wsh32/firefly/hardware/dwm1000_arduino/outs/dwm1000_arduino.pdf

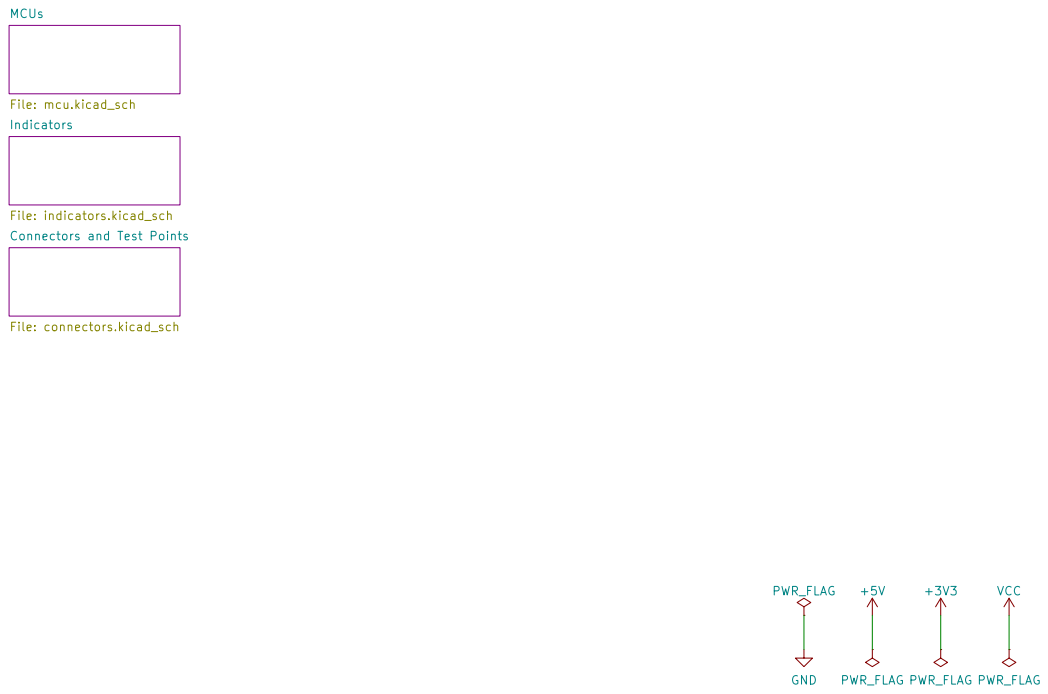
[picture p1: page 1]

Designer: Wesley Soo-Hoo
File: dwm1000_arduino.kicad_sch Sheet: / Olin Robotics - Project Firefly

Id: 1/4 Title: DWM1000 Arduino Breakout

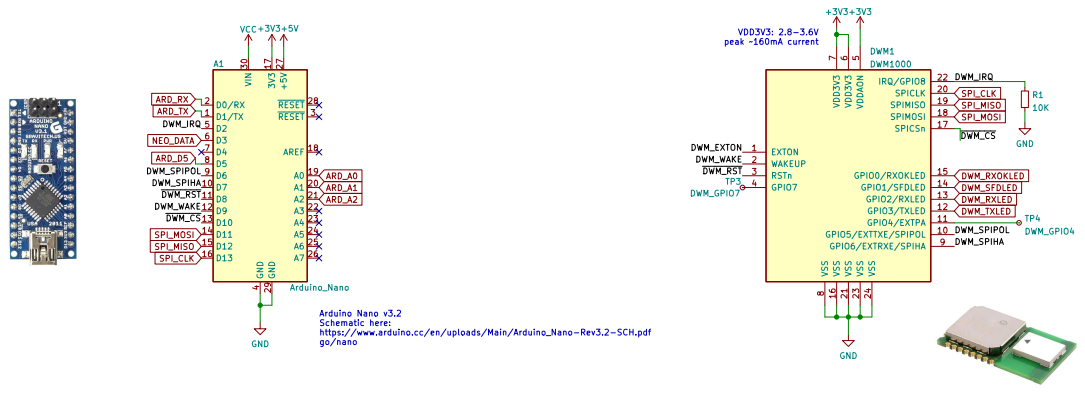
[picture p2: page 2]

~{DWM_CS} Arduino Nano v3.2 Schematic here: https://www.arduino.cc/en/uploads/Main/Arduino_Nano-Rev3.2-SCH.pdf

Designer: Wesley Soo-Hoo
File: mcu.kicad_sch Sheet: /MCUs/ Olin Robotics - Project Firefly

Id: 2/4 Title: DWM1000 Arduino Breakout

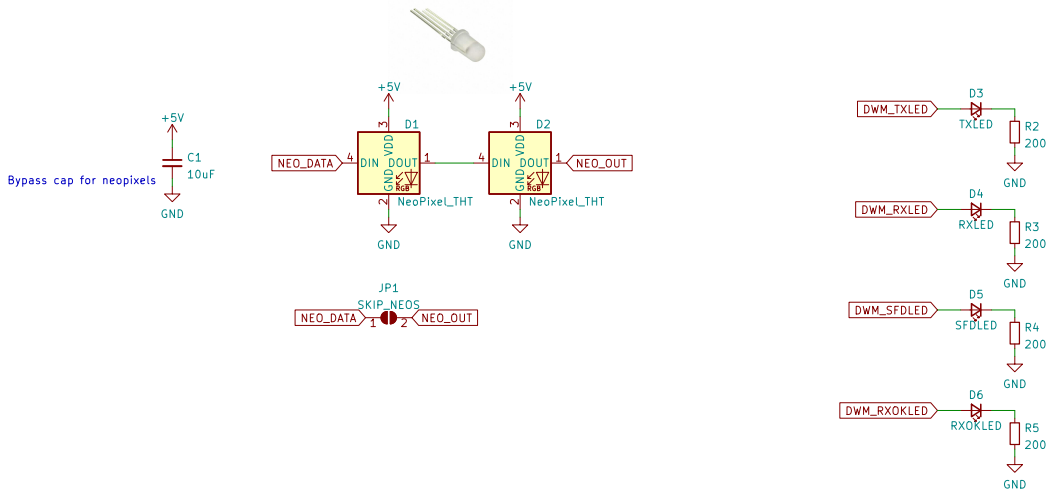
[picture p3: page 3]

NEO_OUT Bypass cap for neopixels

Designer: Wesley Soo-Hoo GND

File: indicators.kicad_sch Sheet: /Indicators/ Olin Robotics - Project Firefly

Id: 3/4 Title: DWM1000 Arduino Breakout

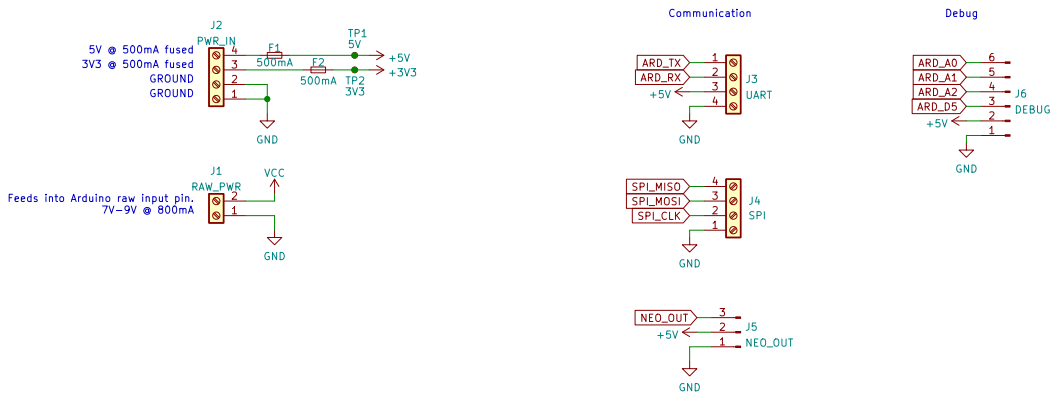
[picture p4: page 4]

Designer: Wesley Soo-Hoo
File: connectors.kicad_sch Sheet: /Connectors and Test Points/ Olin Robotics - Project Firefly

Id: 4/4 Title: DWM1000 Arduino Breakout
