wsh32/firefly/hardware/dwm1000_arduino/dwm1000_arduino.kicad_pcb

## KiCad design hardware/dwm1000_arduino/dwm1000_arduino.kicad_pcb (2022-02-15)

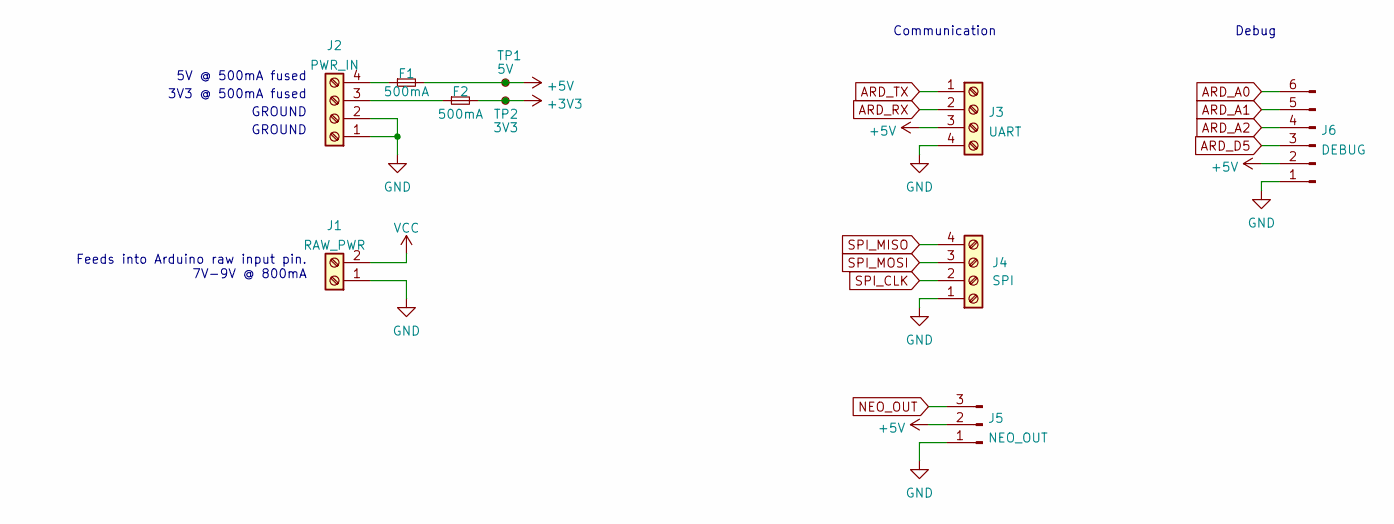
[picture p5: schematic connectors.kicad_sch, DWM1000 Arduino Breakout]

Parts:
F1, F2: 500mA; Fuse_1206_3216Metric_Pad1.42x1.75mm_HandSolder; DigiKey 507-1802-6-ND
J1: RAW_PWR; TerminalBlock_Phoenix_PT-1,5-2-3.5-H_1x02_P3.50mm_Horizontal; DigiKey 277-15481-ND
J2: PWR_IN; TerminalBlock_Phoenix_PT-1,5-4-3.5-H_1x04_P3.50mm_Horizontal; DigiKey 277-1860-ND
J3: UART; TerminalBlock_Phoenix_PT-1,5-4-3.5-H_1x04_P3.50mm_Horizontal; DigiKey 277-1860-ND
J4: SPI; TerminalBlock_Phoenix_PT-1,5-4-3.5-H_1x04_P3.50mm_Horizontal; DigiKey 277-1860-ND
J5: NEO_OUT; PinHeader_1x03_P2.54mm_Vertical
J6: DEBUG; PinHeader_1x06_P2.54mm_Vertical
TP1: 5V; TestPoint_Pad_D2.5mm
TP2: 3V3; TestPoint_Pad_D2.5mm

Connections:
+3V3: F2.2, TP2.1; also elsewhere on the board
+5V: F1.2, J3.3, J5.2, J6.2, TP1.1; also elsewhere on the board
ARD_A0: J6.6; also elsewhere on the board
ARD_A1: J6.5; also elsewhere on the board
ARD_A2: J6.4; also elsewhere on the board
ARD_D5: J6.3; also elsewhere on the board
ARD_RX: J3.2; also elsewhere on the board
ARD_TX: J3.1; also elsewhere on the board
GND: J1.1, J2.1, J2.2, J3.4, J4.1, J5.1, J6.1; also elsewhere on the board
NEO_OUT: J5.3; also elsewhere on the board
unnamed: F1.1, J2.4
unnamed: F2.1, J2.3
SPI_CLK: J4.2; also elsewhere on the board
SPI_MISO: J4.4; also elsewhere on the board
SPI_MOSI: J4.3; also elsewhere on the board
VCC: J1.2; also elsewhere on the board

Notes on the sheet:
GROUND
Feeds into Arduino raw input pin. 7V-9V @ 800mA
5V @ 500mA fused
Communication
3V3 @ 500mA fused
Debug

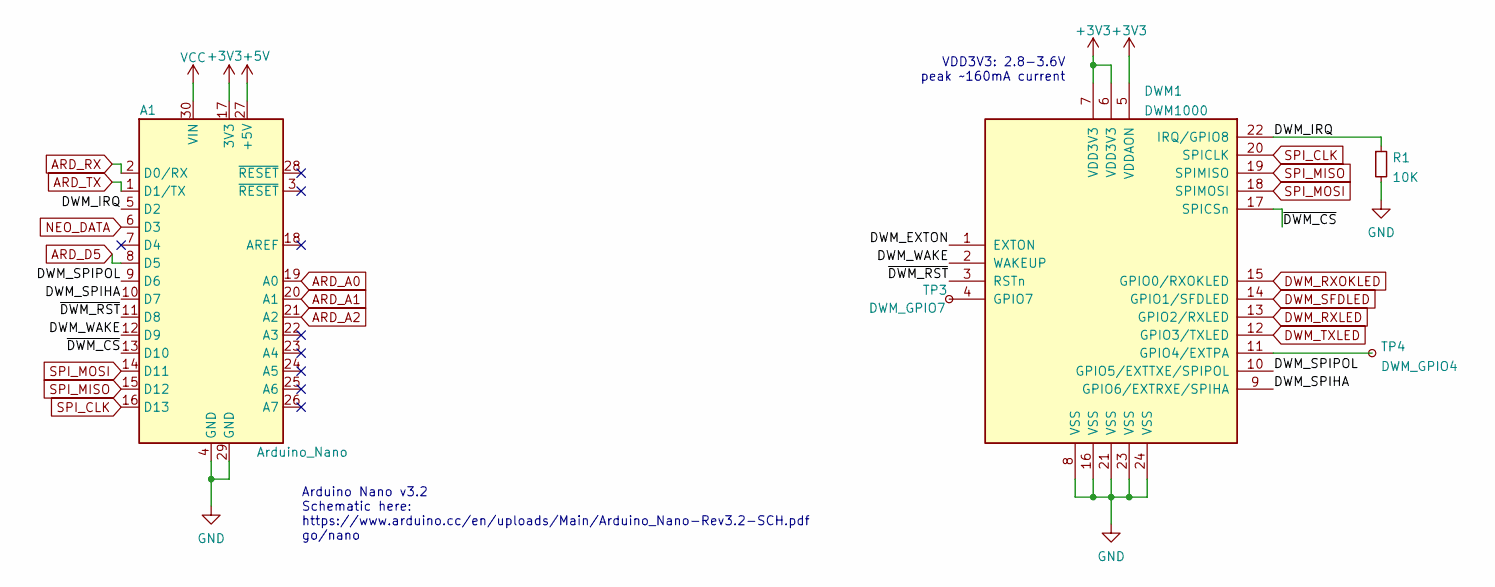
[picture p6: schematic mcu.kicad_sch, DWM1000 Arduino Breakout]

Parts:
A1: Arduino_Nano
DWM1: DWM1000
R1: 10K; R_0805_2012Metric_Pad1.20x1.40mm_HandSolder; DigiKey RMCF0805JT10K0DKR-ND
TP3: DWM_GPIO7
TP4: DWM_GPIO4

Connections:
+3V3: A1.17 (3V3), DWM1.5 (VDDAON), DWM1.6 (VDD3V3), DWM1.7 (VDD3V3); also elsewhere on the board
+5V: A1.27 (+5V); also elsewhere on the board
/MCUs/DWM_EXTON: DWM1.1 (EXTON)
/MCUs/DWM_IRQ: A1.5 (D2), DWM1.22 (IRQ/GPIO8), R1.1
/MCUs/DWM_SPIHA: A1.10 (D7), DWM1.9 (GPIO6/EXTRXE/SPIHA)
/MCUs/DWM_SPIPOL: A1.9 (D6), DWM1.10 (GPIO5/EXTTXE/SPIPOL)
/MCUs/DWM_WAKE: A1.12 (D9), DWM1.2 (WAKEUP)
/MCUs/~DWM_CS: A1.13 (D10), DWM1.17 (SPICSn)
/MCUs/~DWM_RST: A1.11 (D8), DWM1.3 (RSTn)
ARD_A0: A1.19 (A0); also elsewhere on the board
ARD_A1: A1.20 (A1); also elsewhere on the board
ARD_A2: A1.21 (A2); also elsewhere on the board
ARD_D5: A1.8 (D5); also elsewhere on the board
ARD_RX: A1.2 (D0/RX); also elsewhere on the board
ARD_TX: A1.1 (D1/TX); also elsewhere on the board
DWM_RXLED: DWM1.13 (GPIO2/RXLED); also elsewhere on the board
DWM_RXOKLED: DWM1.15 (GPIO0/RXOKLED); also elsewhere on the board
DWM_SFDLED: DWM1.14 (GPIO1/SFDLED); also elsewhere on the board
DWM_TXLED: DWM1.12 (GPIO3/TXLED); also elsewhere on the board
GND: A1.4 (GND), A1.29 (GND), DWM1.8 (VSS), DWM1.16 (VSS), DWM1.21 (VSS), DWM1.23 (VSS), DWM1.24 (VSS), R1.2; also elsewhere on the board
NEO_DATA: A1.6 (D3); also elsewhere on the board
unnamed: DWM1.4 (GPIO7), TP3.1
unnamed: DWM1.11 (GPIO4/EXTPA), TP4.1
SPI_CLK: A1.16 (D13), DWM1.20 (SPICLK); also elsewhere on the board
SPI_MISO: A1.15 (D12), DWM1.19 (SPIMISO); also elsewhere on the board
SPI_MOSI: A1.14 (D11), DWM1.18 (SPIMOSI); also elsewhere on the board
VCC: A1.30 (VIN); also elsewhere on the board

Notes on the sheet:
VDD3V3: 2.8-3.6V peak ~160mA current
Arduino Nano v3.2 Schematic here: https://www.arduino.cc/en/uploads/Main/Arduino_Nano-Rev3.2-SCH.pdf go/nano

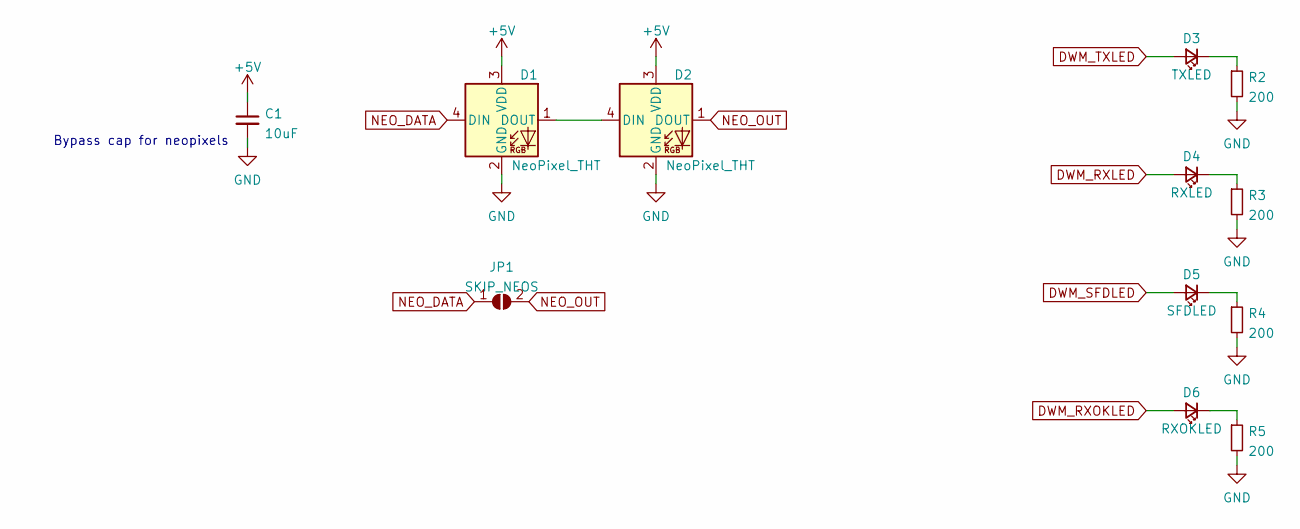
[picture p7: schematic indicators.kicad_sch, DWM1000 Arduino Breakout]

Parts:
C1: 10uF; C_0805_2012Metric_Pad1.18x1.45mm_HandSolder; DigiKey 445-12654-6-ND
D1, D2: NeoPixel_THT; LED_D5.0mm-4_RGB; DigiKey 1528-1959-ND
D3: TXLED; LED_0805_2012Metric_Pad1.15x1.40mm_HandSolder; DigiKey 475-2560-6-ND
D4: RXLED; LED_0805_2012Metric_Pad1.15x1.40mm_HandSolder; DigiKey 475-2560-6-ND
D5: SFDLED; LED_0805_2012Metric_Pad1.15x1.40mm_HandSolder; DigiKey 475-2560-6-ND
D6: RXOKLED; LED_0805_2012Metric_Pad1.15x1.40mm_HandSolder; DigiKey 475-2560-6-ND
JP1: SKIP_NEOS; SolderJumper-2_P1.3mm_Open_RoundedPad1.0x1.5mm
R2, R3, R4, R5: 200; R_0805_2012Metric_Pad1.20x1.40mm_HandSolder; DigiKey RMCF0805JT200RDKR-ND

Connections:
+5V: C1.1, D1.3 (VDD), D2.3 (VDD); also elsewhere on the board
DWM_RXLED: D4.2 (A); also elsewhere on the board
DWM_RXOKLED: D6.2 (A); also elsewhere on the board
DWM_SFDLED: D5.2 (A); also elsewhere on the board
DWM_TXLED: D3.2 (A); also elsewhere on the board
GND: C1.2, D1.2 (GND), D2.2 (GND), R2.2, R3.2, R4.2, R5.2; also elsewhere on the board
NEO_DATA: D1.4 (DIN), JP1.1 (A); also elsewhere on the board
NEO_OUT: D2.1 (DOUT), JP1.2 (B); also elsewhere on the board
unnamed: D1.1 (DOUT), D2.4 (DIN)
unnamed: D3.1 (K), R2.1
unnamed: D4.1 (K), R3.1
unnamed: D5.1 (K), R4.1
unnamed: D6.1 (K), R5.1

Notes on the sheet:
Bypass cap for neopixels

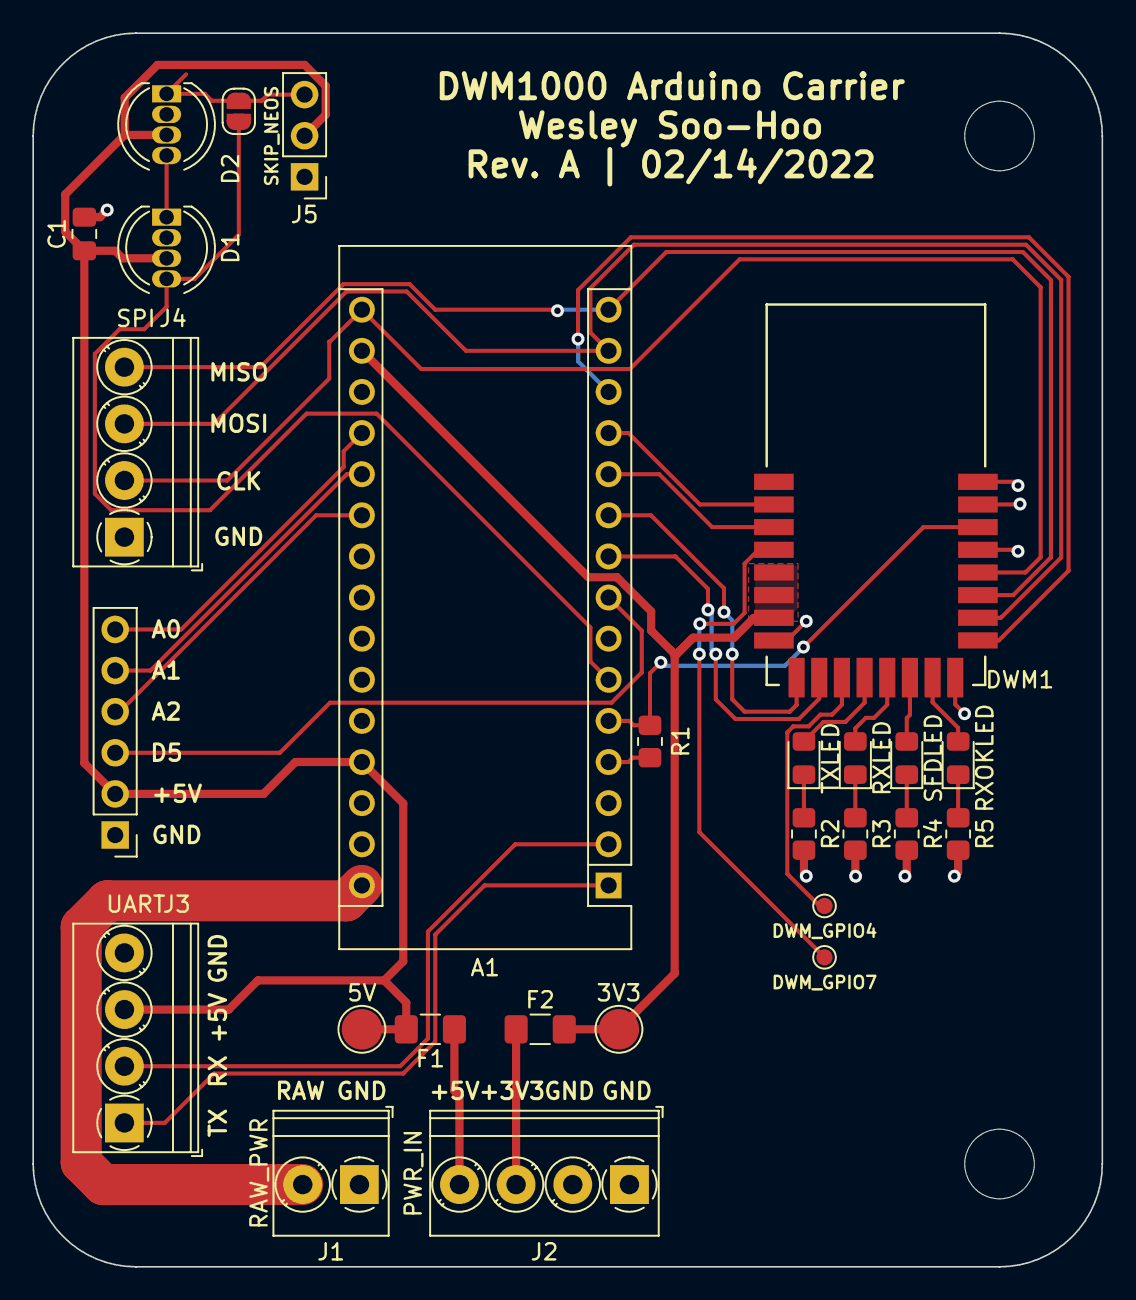
[picture p8: board dwm1000_arduino.kicad_pcb from above]

Board: 2 copper layers, 66.0 x 76.2 mm, 27 parts (0 on the bottom side), 34 nets.
