wsh32/firefly/(commit log)

2022-02-12 first rev dwm1000 schematic
    [connectors.kicad_sch, dwm1000_arduino.kicad_pcb, dwm1000_arduino.kicad_sch, indicators.kicad_sch, mcu.kicad_sch]
2022-02-13 finixh schematic and first pass layout
    [connectors.kicad_sch, dwm1000_arduino.kicad_pcb, dwm1000_arduino.kicad_sch, indicators.kicad_sch, mcu.kicad_sch]
2022-02-13 update schematic pdf
2022-02-14 fix ground plane, fix connector placement, add silkscreen
    [dwm1000_arduino.kicad_pcb]
2022-02-15 add gerbers to gitignore
2022-02-15 remove silkscreen refs for the mounting holes
    [dwm1000_arduino.kicad_pcb]
2022-04-01 anchor and tag arduino firmware
